Irfan4hmd/Entomoscope_LIB/enimas2-main/UserInterface/imgs/490-415-max.png

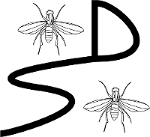
enimas2-main/UserInterface/imgs/490-415-max.png
