Irfan4hmd/Entomoscope_LIB/enimas2-main/UserInterface/imgs/camera_settings.png

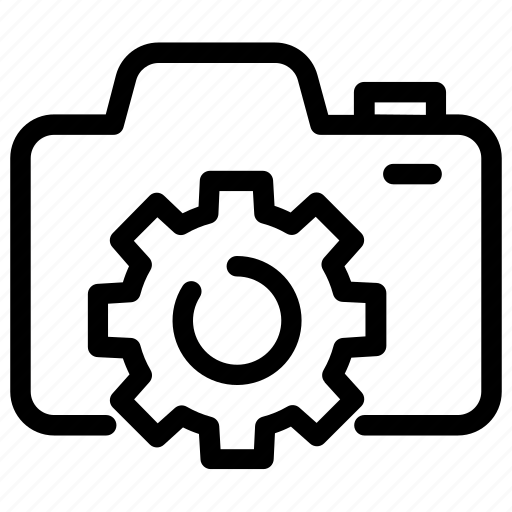
enimas2-main/UserInterface/imgs/camera_settings.png
