Irfan4hmd/Entomoscope_LIB/enimas2-main/UserInterface/imgs/reference_axis.png

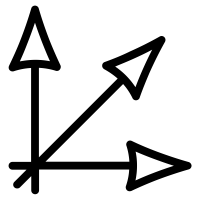
enimas2-main/UserInterface/imgs/reference_axis.png
