Irfan4hmd/Entomoscope_LIB/enimas2-main/UserInterface/imgs/take_stack.png

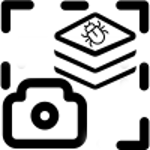
enimas2-main/UserInterface/imgs/take_stack.png
