Irfan4hmd/Entomoscope_LIB/enimas2-main/UserInterface/Wiki_Images/arduino_device_choice.png

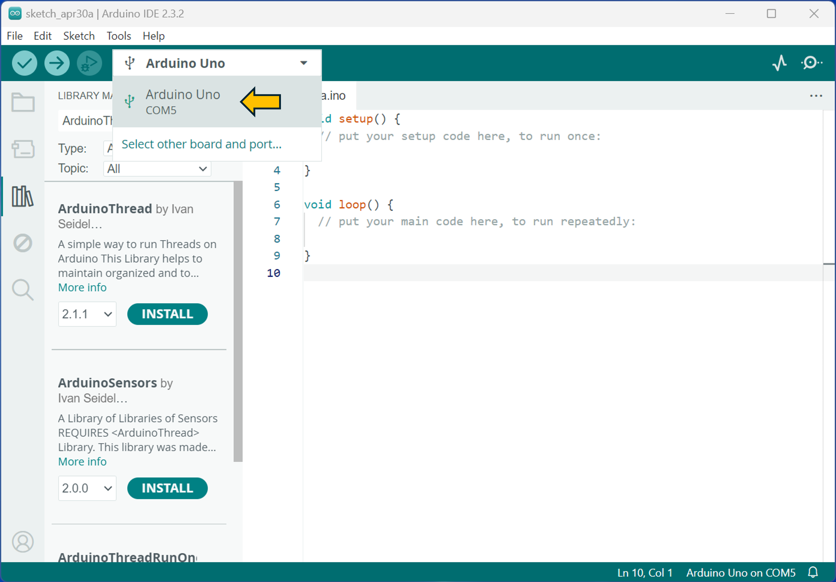
enimas2-main/UserInterface/Wiki_Images/arduino_device_choice.png
