Irfan4hmd/Entomoscope_LIB/enimas2-main/UserInterface/Wiki_Images/arduino_library_manager.png

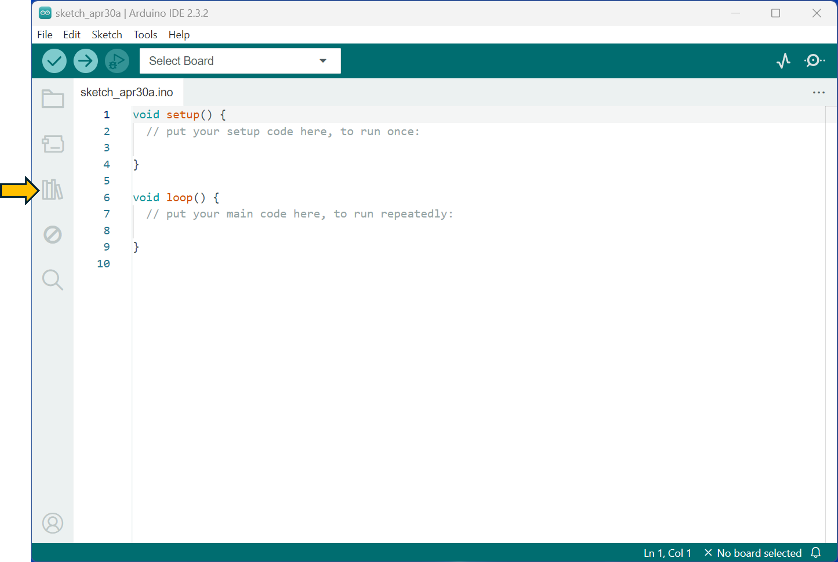
enimas2-main/UserInterface/Wiki_Images/arduino_library_manager.png
