Irfan4hmd/Entomoscope_LIB/enimas2-main/UserInterface/Wiki_Images/base_plate_explosion_arduino.png

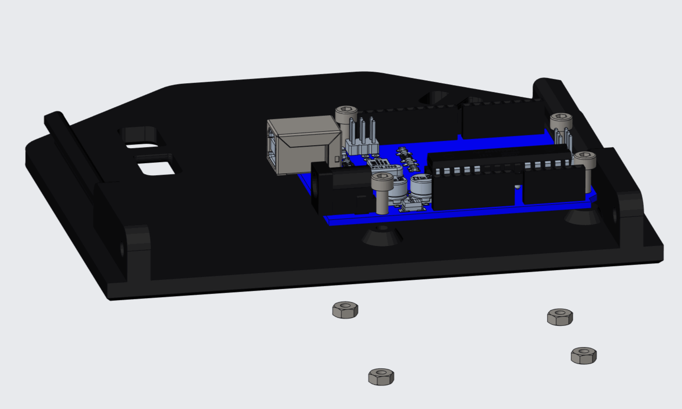
enimas2-main/UserInterface/Wiki_Images/base_plate_explosion_arduino.png
