Irfan4hmd/Entomoscope_LIB/enimas2-main/UserInterface/Wiki_Images/base_plate_final.jpg

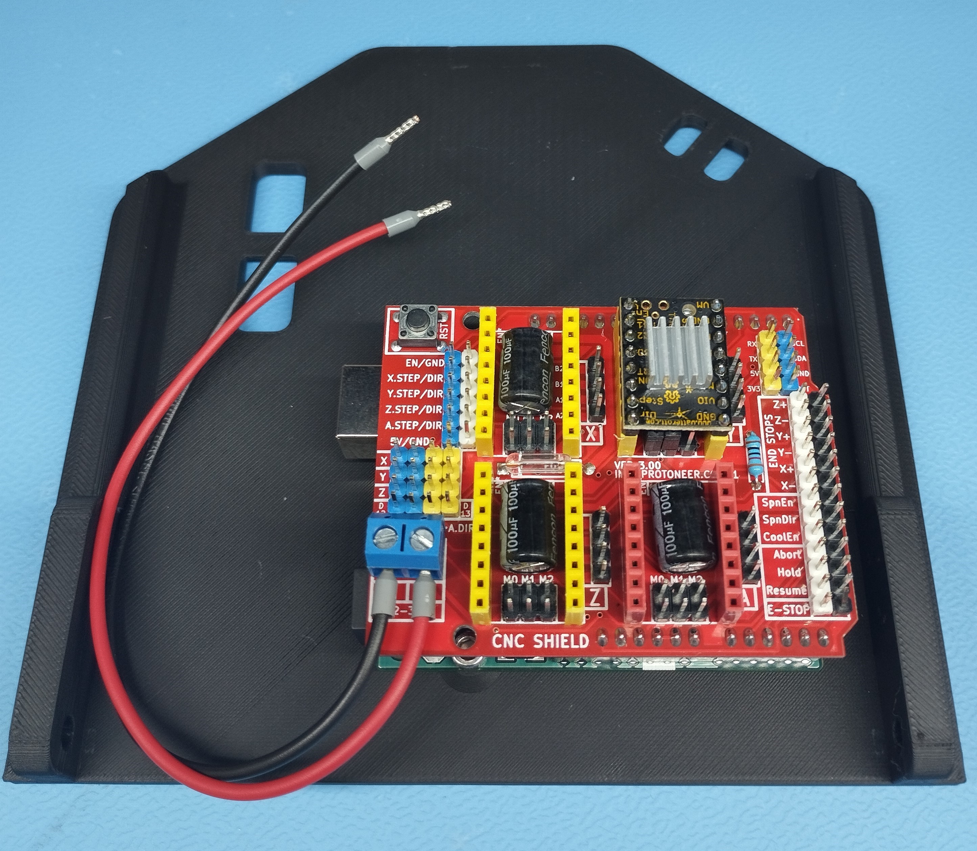
enimas2-main/UserInterface/Wiki_Images/base_plate_final.jpg
