Irfan4hmd/Entomoscope_LIB/enimas2-main/UserInterface/Wiki_Images/bearing_alignment.jpg

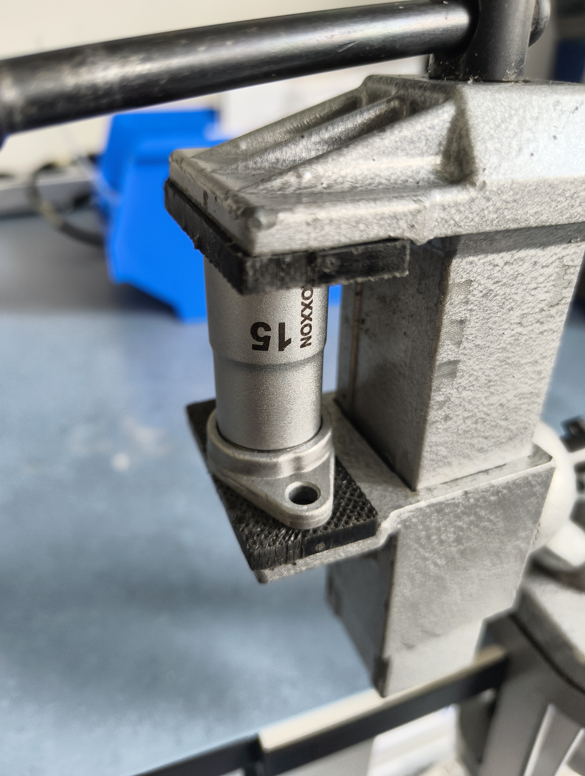
enimas2-main/UserInterface/Wiki_Images/bearing_alignment.jpg
