Irfan4hmd/Entomoscope_LIB/enimas2-main/UserInterface/Wiki_Images/cable_brackets.JPG

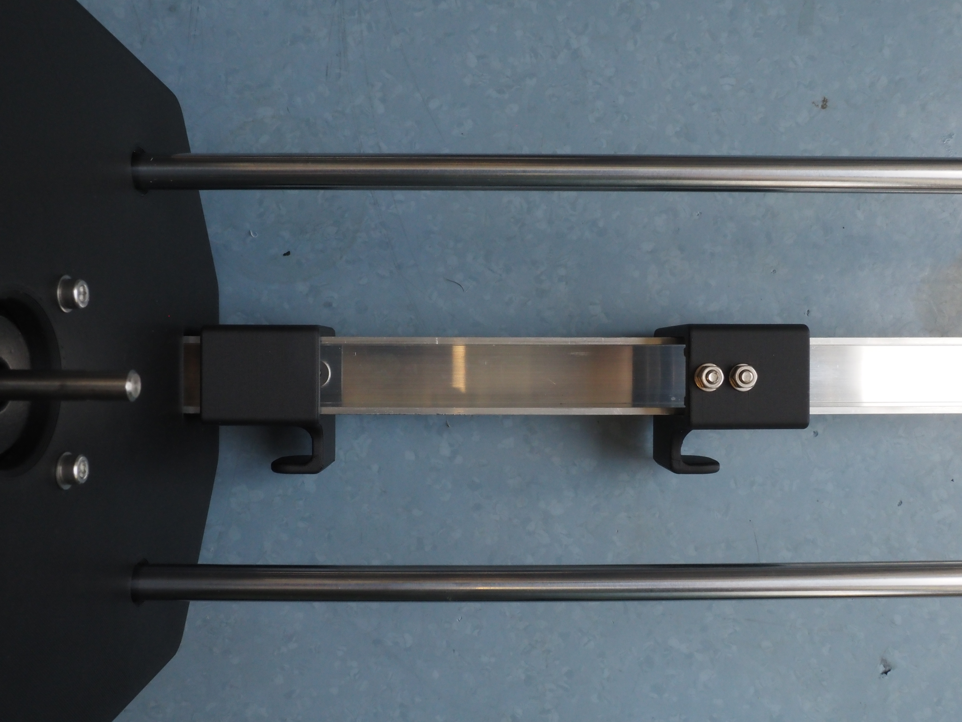
enimas2-main/UserInterface/Wiki_Images/cable_brackets.JPG
