Irfan4hmd/Entomoscope_LIB/enimas2-main/UserInterface/Wiki_Images/camera_carrier_explosion.png

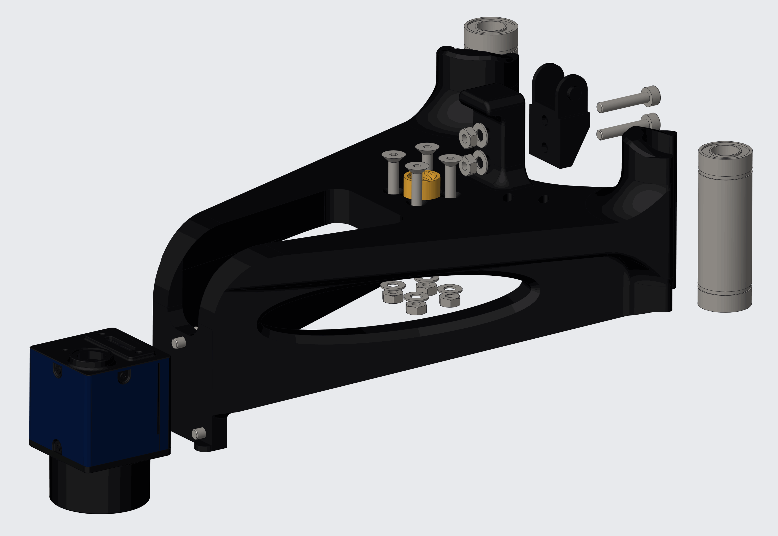
enimas2-main/UserInterface/Wiki_Images/camera_carrier_explosion.png
