Irfan4hmd/Entomoscope_LIB/enimas2-main/UserInterface/Wiki_Images/clamps_explosion.png

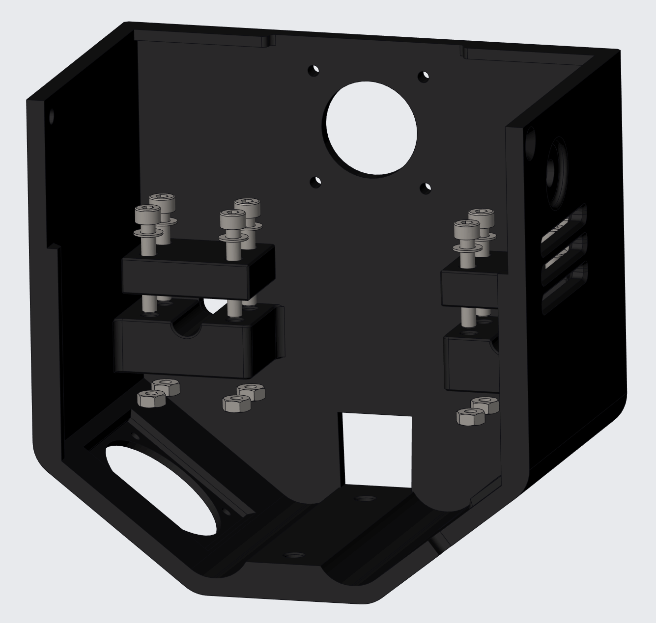
enimas2-main/UserInterface/Wiki_Images/clamps_explosion.png
