Irfan4hmd/Entomoscope_LIB/enimas2-main/UserInterface/Wiki_Images/cnc_shield_jumpers.png

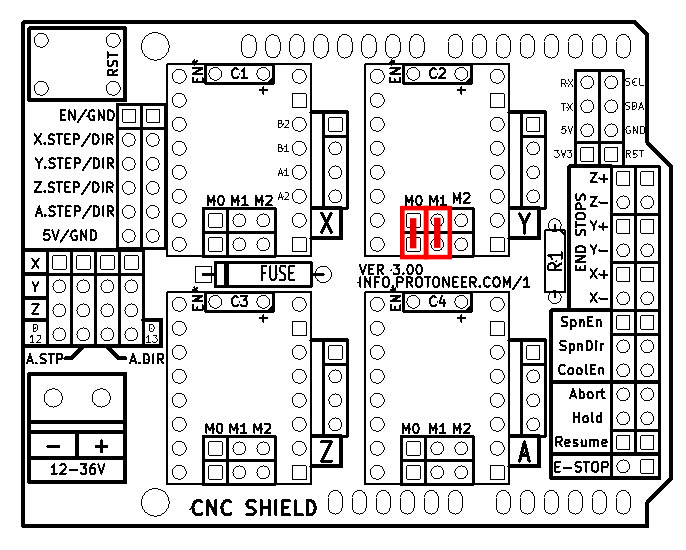
enimas2-main/UserInterface/Wiki_Images/cnc_shield_jumpers.png
