Irfan4hmd/Entomoscope_LIB/enimas2-main/UserInterface/Wiki_Images/coupler_distance.jpg

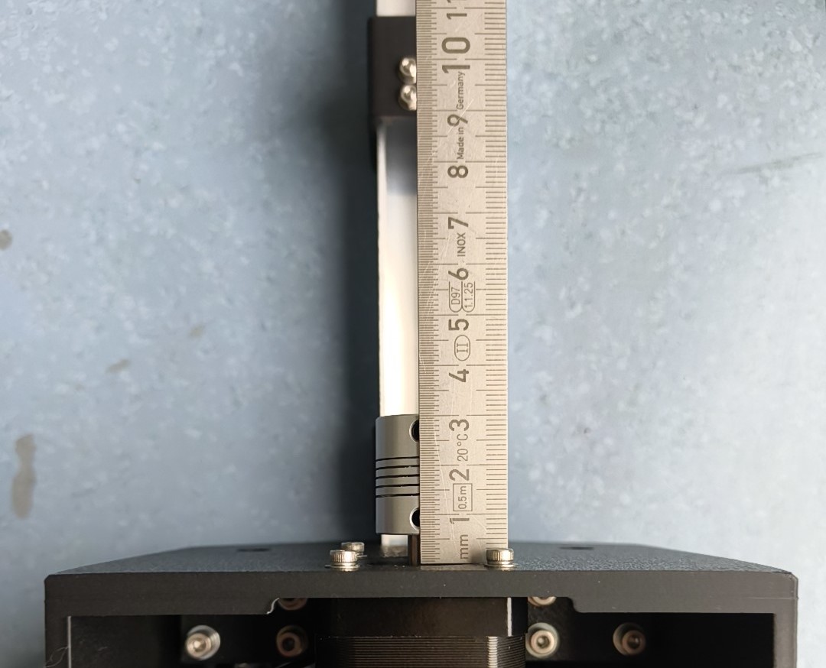
enimas2-main/UserInterface/Wiki_Images/coupler_distance.jpg
