Irfan4hmd/Entomoscope_LIB/enimas2-main/UserInterface/Wiki_Images/diffuser_plates.jpg

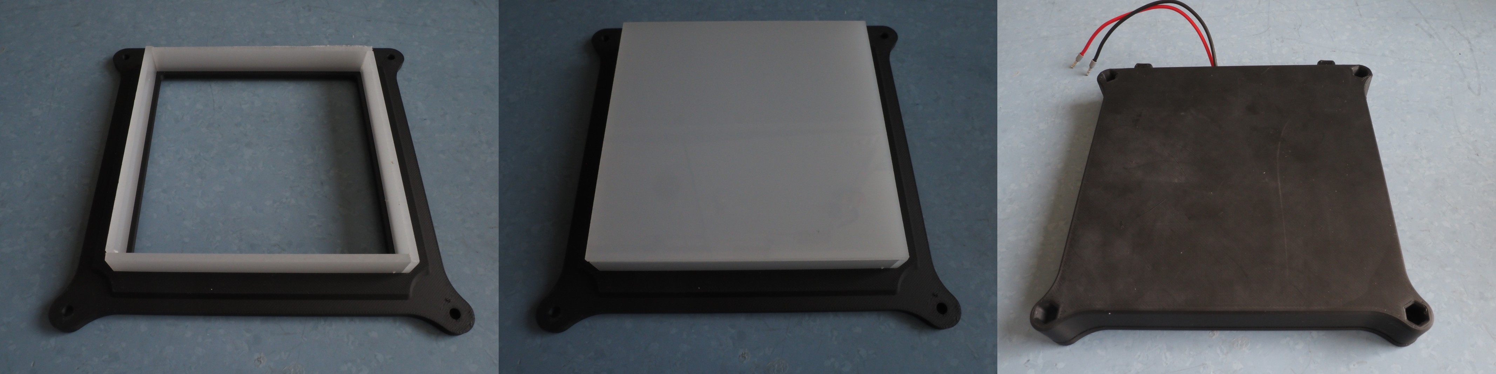
enimas2-main/UserInterface/Wiki_Images/diffuser_plates.jpg
