Irfan4hmd/Entomoscope_LIB/enimas2-main/UserInterface/Wiki_Images/drag_chain.jpg

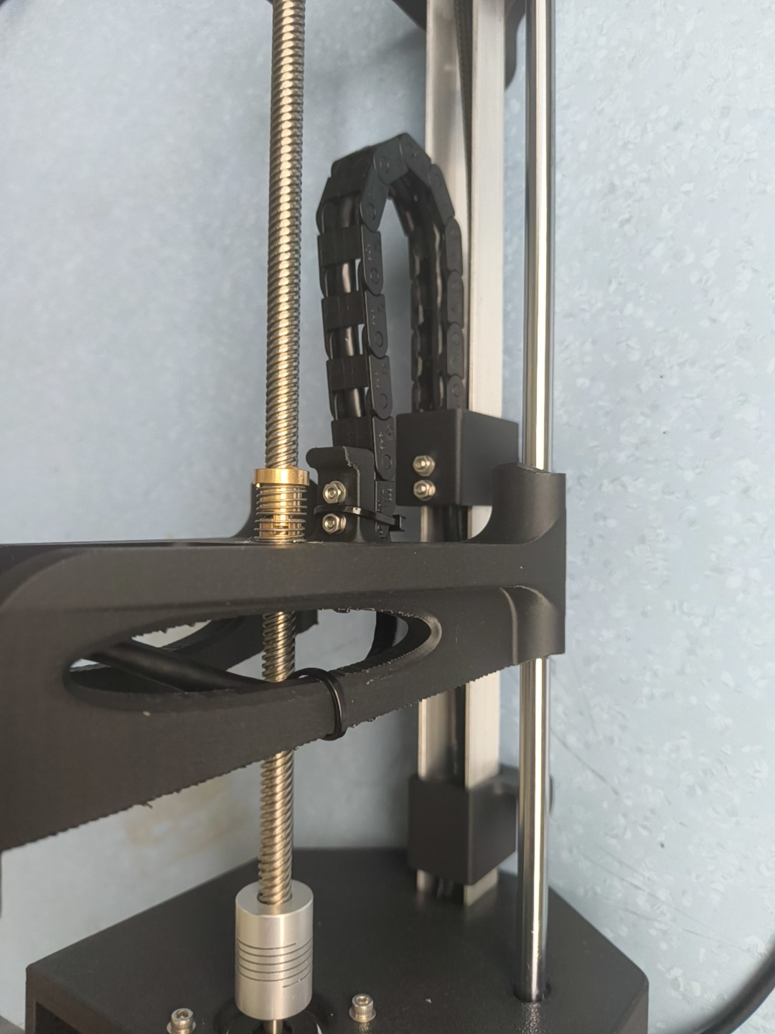
enimas2-main/UserInterface/Wiki_Images/drag_chain.jpg
