Irfan4hmd/Entomoscope_LIB/enimas2-main/UserInterface/Wiki_Images/drag_chain_bracket_explosion.png

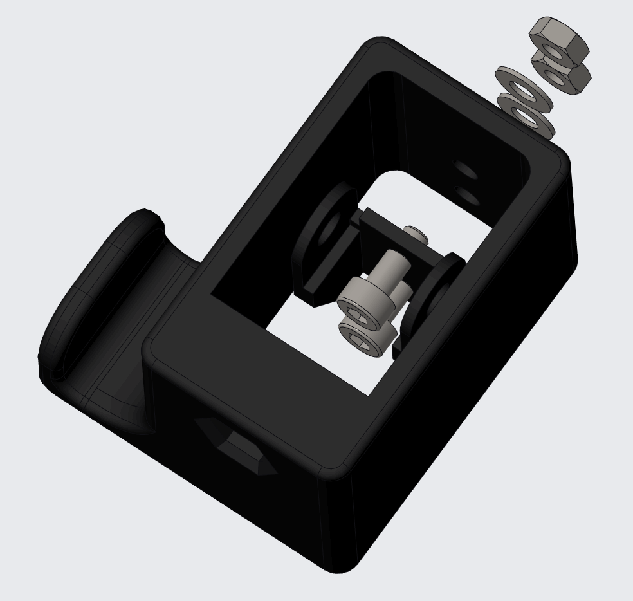
enimas2-main/UserInterface/Wiki_Images/drag_chain_bracket_explosion.png
