Irfan4hmd/Entomoscope_LIB/enimas2-main/UserInterface/Wiki_Images/electronics_base.JPG

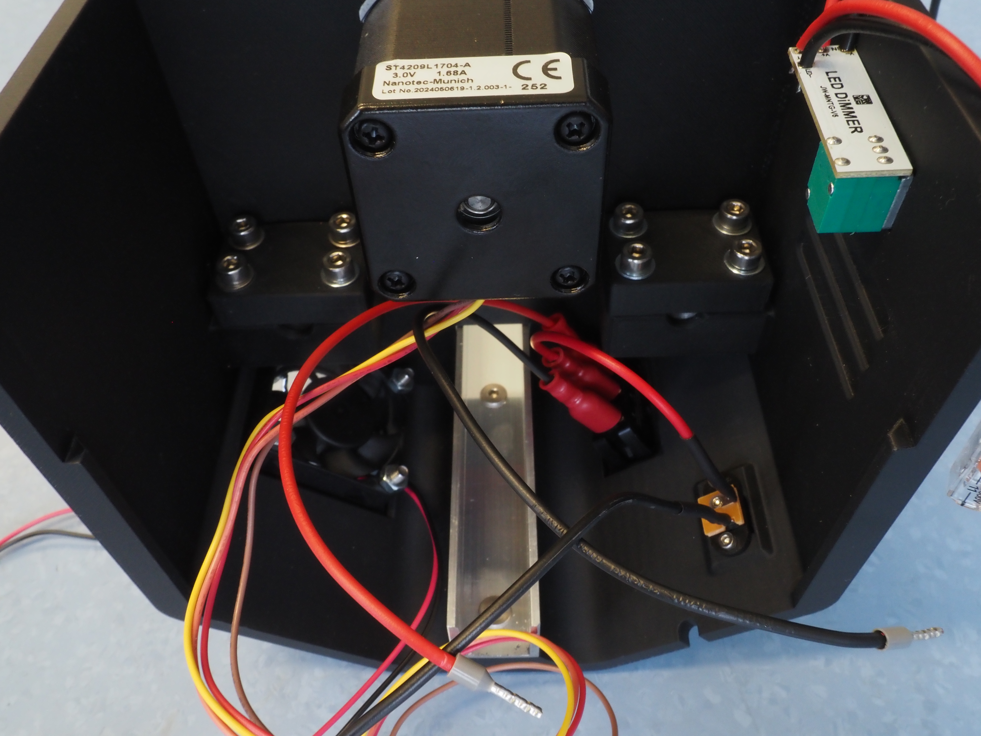
enimas2-main/UserInterface/Wiki_Images/electronics_base.JPG
