Irfan4hmd/Entomoscope_LIB/enimas2-main/UserInterface/Wiki_Images/endswitch_circuit_diagram.png

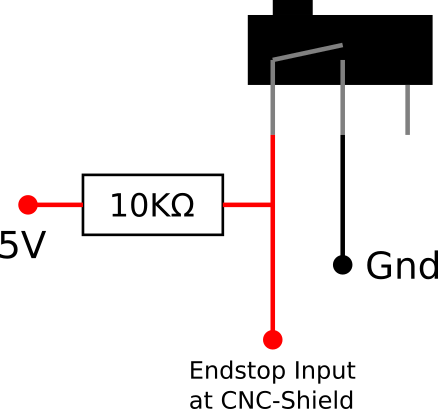
enimas2-main/UserInterface/Wiki_Images/endswitch_circuit_diagram.png
