Irfan4hmd/Entomoscope_LIB/enimas2-main/UserInterface/Wiki_Images/endswitch_cnc_connection.png

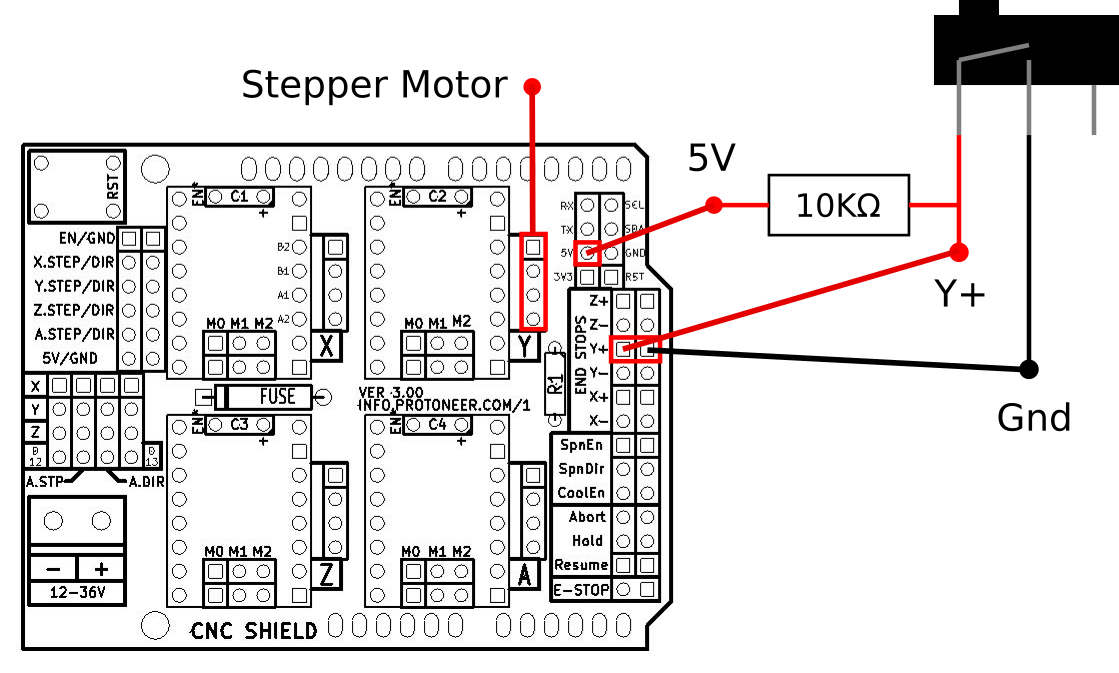
enimas2-main/UserInterface/Wiki_Images/endswitch_cnc_connection.png
