Irfan4hmd/Entomoscope_LIB/enimas2-main/UserInterface/Wiki_Images/lighting_unit_explosion.png

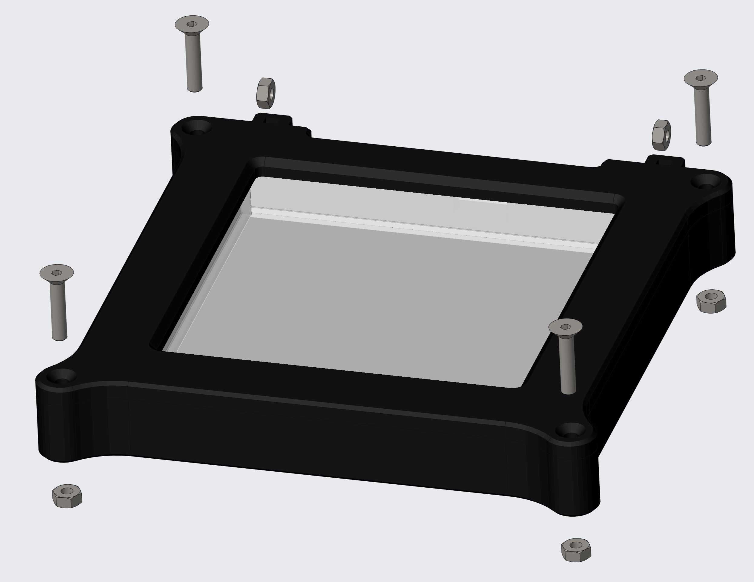
enimas2-main/UserInterface/Wiki_Images/lighting_unit_explosion.png
