Irfan4hmd/Entomoscope_LIB/enimas2-main/UserInterface/Wiki_Images/linear_top_explosion.png

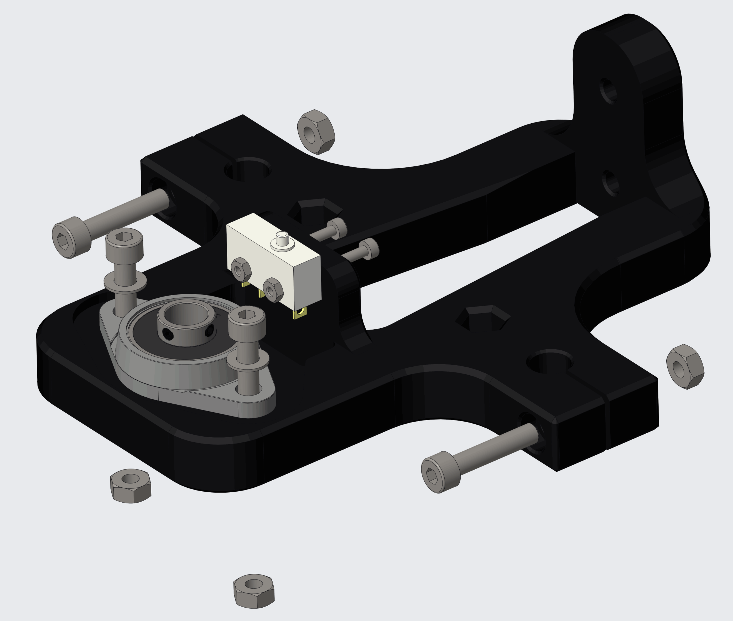
enimas2-main/UserInterface/Wiki_Images/linear_top_explosion.png
