Irfan4hmd/Entomoscope_LIB/enimas2-main/UserInterface/Wiki_Images/power_supply_cables.jpg

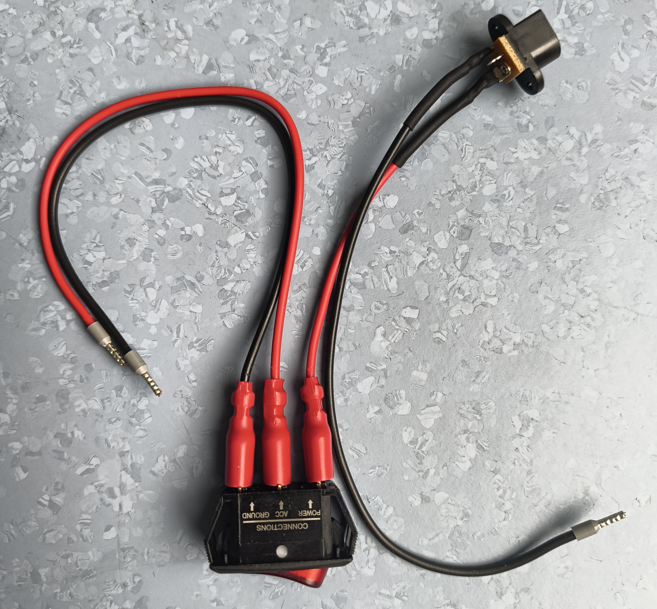
enimas2-main/UserInterface/Wiki_Images/power_supply_cables.jpg
