Irfan4hmd/Entomoscope_LIB/enimas2-main/UserInterface/Wiki_Images/tilted_bearing.jpg

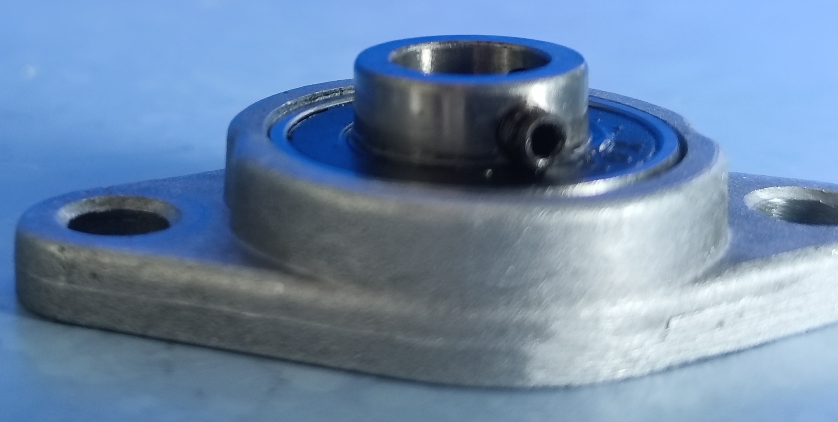
enimas2-main/UserInterface/Wiki_Images/tilted_bearing.jpg
