Irfan4hmd/Entomoscope_LIB/enimas2-main/UserInterface/Wiki_Images/top_alignment.jpg

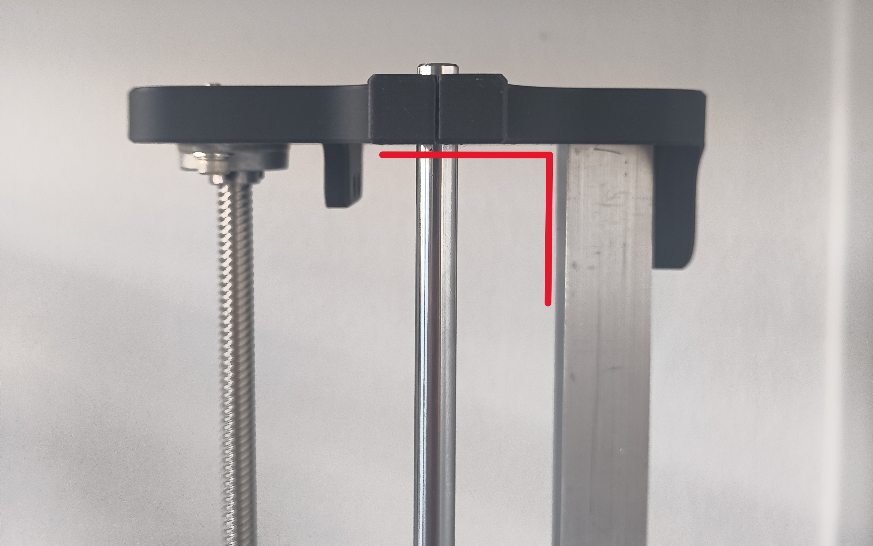
enimas2-main/UserInterface/Wiki_Images/top_alignment.jpg
