Irfan4hmd/Entomoscope_LIB/enimas2-main/UserInterface/Wiki_Images/top_cable.JPG

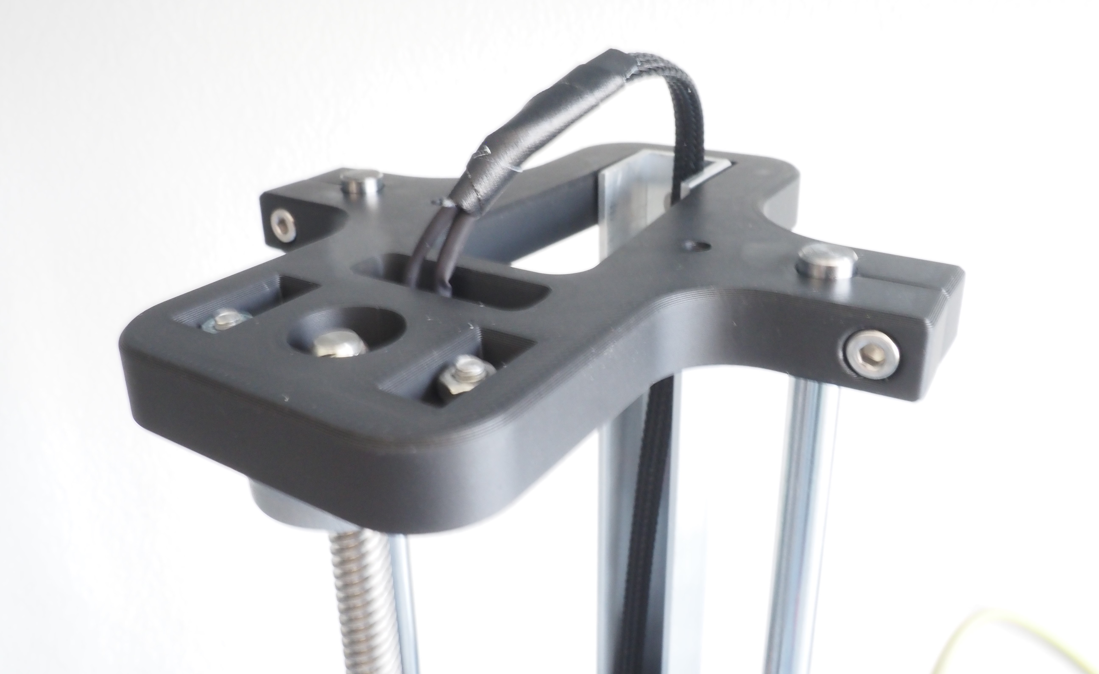
enimas2-main/UserInterface/Wiki_Images/top_cable.JPG
