Irfan4hmd/Entomoscope_LIB/enimas2-main/UserInterface/Wiki_Images/top_lid.JPG

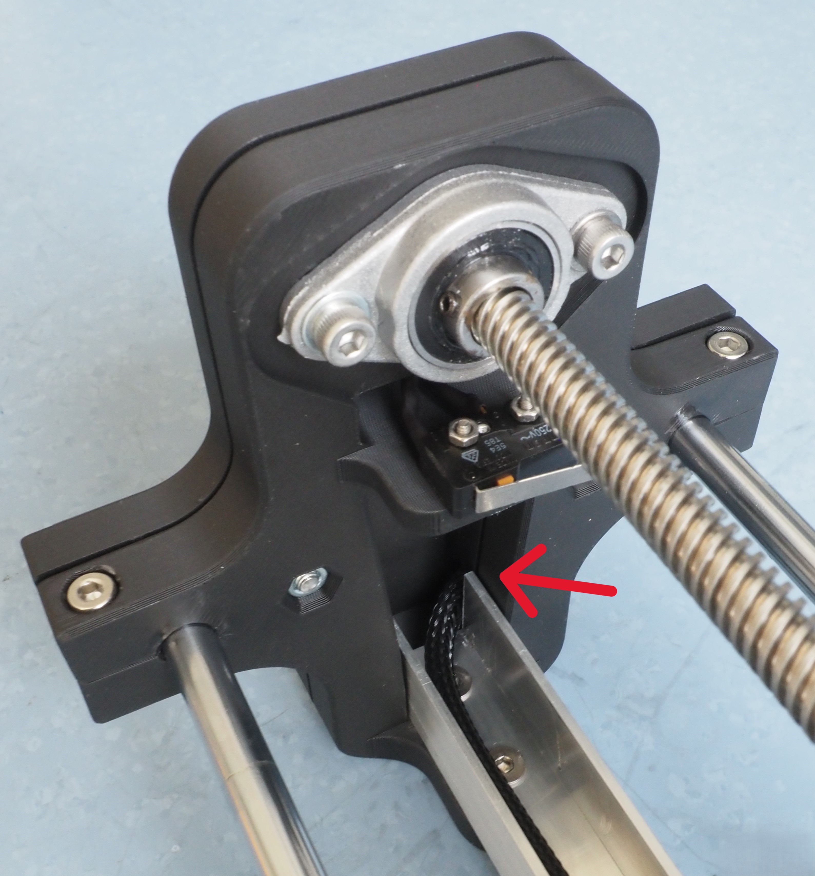
enimas2-main/UserInterface/Wiki_Images/top_lid.JPG
