Irfan4hmd/Entomoscope_LIB/enimas2-main/UserInterface/Wiki_Images/u-profile_explosion.png

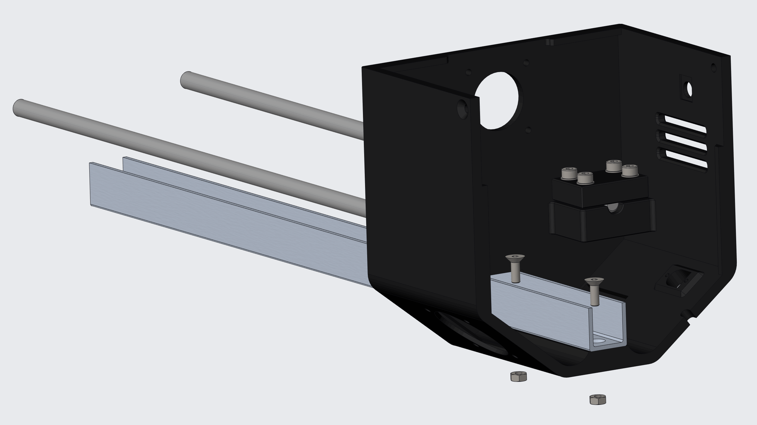
enimas2-main/UserInterface/Wiki_Images/u-profile_explosion.png
