Irfan4hmd/Entomoscope_LIB/enimas2-main/UserInterface/Wiki_Images/usb_hub.jpg

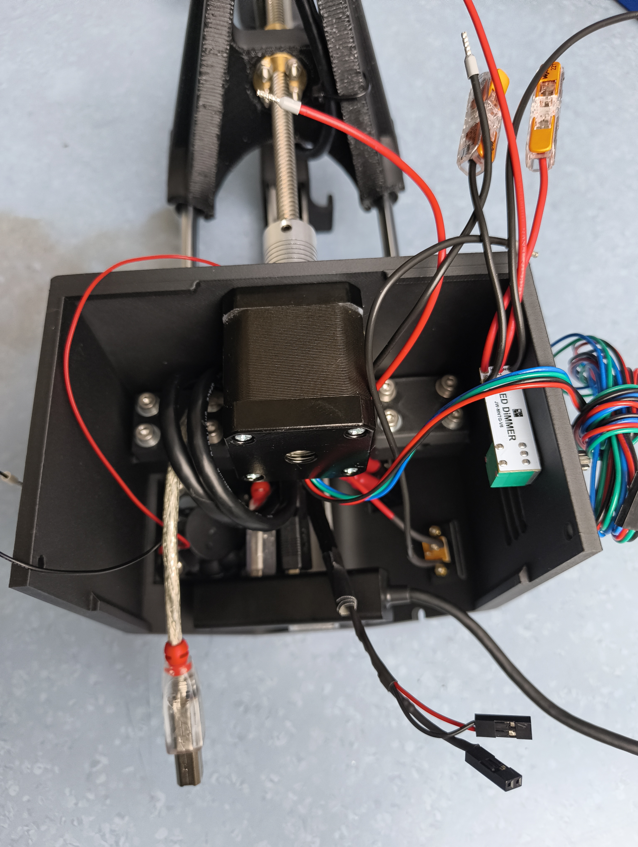
enimas2-main/UserInterface/Wiki_Images/usb_hub.jpg
