Irfan4hmd/Entomoscope_LIB/enimas2-main/UserInterface/Partslist/Entomoscope_2_0_Partslist_NEW.xlsx

Sheet: Entomoscope 3.0 Parts
Category | Part |  | Category | Description | Quantity per Set Up | Link | Price/unit | Total | Units/Assembly | In Stock | Estimated Filament use (for 3D-printed parts only) [g] | Estimated printing time (for 3D-printed parts only)
Base_Assembly | Base |  | 3D Printed |  | 1 |  |  | 0.94 |  |  | 59
 | CNC_Shield |  | Purchased | CNC Shield V3 Arduino UNO | 1 | https://www.roboter-bausatz.de/p/uno-cnc-shield-v3-kompatibel-mit-arduino-uno | 5.22 | 5.22 | 1 | 21 | NaN |  | Filament price €/kg | 16
 | Arduino UNO | Options | Purchased | UNO R3 ATMEGA328P Board Arduino kompatibel | 1 | https://www.roboter-bausatz.de/p/uno-r3-atmega328p-atmega16u2-board-arduino-kompatibel | 9.95 | 9.95 | 1 | 25 | NaN
 |  |  | Purchased | Joy-it ARD_R3DIP-P (Reichelt) | 0 | https://www.reichelt.de/de/de/shop/produkt/arduino_kompatibles_uno_board_atmega328p-395380 | 13.70 | 0.00 |  |  | NaN
 |  |  | Purchased | Joy-it ARD_R3DIP-P (Conrad) | 0 | https://www.conrad.de/de/p/joy-it-ard-r3dip-p-mikrocontroller-arduino-r3dip-precision-uno-kompatible-3344408.html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 | 14.90 | 0.00 |  |  | NaN
 | Stepper_Driver |  | Purchased | TMC 2209 Stepper Motor Driver | 1 | https://www.roboter-bausatz.de/p/mks-tmc2209-schrittmotortreiber | 5.95 | 5.95 | 1 | 1 | NaN
 | LED_Dimmer |  | Purchased | LED Dimmer DC 3.7 - 24V | 1 | https://www.roboter-bausatz.de/p/led-dimmer-spannungswandler-modul-dc-3-7-24v | 4.62 | 4.62 | 1 | 15 | NaN
 | Dimmer_Button |  | Purchased | Potentiometer Knobs 30 PACK | 0.03333333333 | https://www.roboter-bausatz.de/p/sortiment-potentiometer-knoepfe-30-stueck | 1.39 | 0.05 | 1 | 20 | NaN
 | Wago_221_2 |  | Purchased | Wago 221 Splicing Connector, 1 Conductor | 2 | https://www.conrad.de/de/p/wago-221-2411-verbindungsklemme-flexibel-0-14-4-mm-starr-0-2-4-mm-polzahl-1-1-st-transparent-orange-2355190.html | 0.52 | 1.04 | 2 | >20 | NaN
 | Wago_221_5 |  | Purchased | Wago 221 Splicing Connector, 5 Conductor | 2 | https://www.conrad.de/de/p/wago-221-415-1-221-verbindungsklemme-flexibel-0-14-4-mm-starr-0-2-4-mm-polzahl-5-1-st-transparent-orange-1188438.html | 1.49 | 2.98 | 2 | 9 | NaN
 | USB_Hub |  | Purchased | Axagon 4 Port | 1 | https://www.reichelt.de/de/de/shop/produkt/usb_3_0_4-port_hub_4xa_usb-a-kabel_120_cm-346300 | 13.90 | 13.90 | 1 | 15 | NaN
 | USB-Cable |  | Purchased | USB A to B, 0.2m | 1 | https://www.reichelt.de/de/de/shop/produkt/usb_2_0_kabel_a_stecker_auf_b_stecker_0_2_m-378352 | 2.15 | 2.15 | 1 | 20 | NaN
 |  |  |  |  |  |  |  | 0.00
Linear_Assembly | Linear_Rail_Base |  | 3D Printed |  | 1 |  |  | 2.40 |  |  | 150
 | Linear_Rail_Top |  | 3D Printed |  | 1 |  |  | 0.80 |  |  | 50
 | Linear_Rod_Clamp |  | 3D Printed |  | 2 |  |  | 0.08 |  |  | 5
 | Linear_Rail_Top_lid |  | 3D Printed |  | 1 |  |  | 0.61 |  |  | 38
 | Linear_Rod |  | Purchased | 350x8mm | 2 | https://www.roboter-bausatz.de/p/linearwelle-8-mm-x-350-mm | 6.65 | 13.30 | 2 | 15 | NaN
 | Threaded_Rod_T8x8 |  | Purchased | 300x8mm | 1 | https://www.roboter-bausatz.de/p/trapezgewindespindel-fuer-3d-drucker-fraese-usw.-300x8mm-edelstahl-messingmutter | 7.95 | 7.95 | 1 | 20 | NaN
 | U-Profile |  |  |  | 1 |  |  | 0.00 |  | 1 | NaN
 | KFL08 |  | Purchased | 8mm Bearing with Flange 2 PACK | 0.5 | https://www.roboter-bausatz.de/p/kfl08-stehlager-mit-flansch-2-stueck | 3.71 | 1.85 | 1 | 10 | NaN
 | 5-8mm_Shaft_Coupler | Options | Purchased | Flexible Coupler | 1 | https://www.roboter-bausatz.de/p/flexible-wellenkupplung-5mm-auf-8mm | 1.55 | 1.55 | 1 | 18 | NaN
 |  |  | Purchased | Claw Coupler D20L25 | 0 | https://www.roboter-bausatz.de/p/5-mm-auf-8-mm-klauenkupplung-wellenkupplung-d20l25 | 4.99 | 0.00 |  |  | NaN
 | Stepper_Motor | Options | Purchased | Joy-IT, Nema 17 (Reichelt) | 1 | https://www.reichelt.de/de/de/shop/produkt/schrittmotor_hoch-drehmoment_hybrid_2-phasen-219027 | 25.80 | 25.80 | 1 | 19 | NaN
 |  |  | Purchased | Joy-IT, Nema 17 (Conrad) | 0 | https://www.conrad.de/de/p/joy-it-schrittmotor-nema-17-01-nema-17-01-0-4-nm-1-68-a-wellen-durchmesser-5-mm-1597325.html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 | 29.99 | 0.00 |  |  | NaN
 | 12V_DC_Fan | Options | Purchased | 40x40mm for 3D Printer Hot End | 1 | https://www.roboter-bausatz.de/p/12v-luefter-40-40-10mm-fuer-extruder-hot-end | 1.09 | 1.09 | 1 | 12 | NaN
 |  |  | Purchased | 40x40mm Sunon HA40101V4-1000U-A99 | 0 | https://www.conrad.de/de/p/sunon-ha40101v4-1000u-a99-axialluefter-12-v-dc-9-2-m-h-l-x-b-x-h-40-x-40-x-10-mm-1719608.html | 3.79 | 0.00 |  |  | NaN
 | Fan_Cover |  | Purchased | 40x40mm Fan Cover | 1 | https://www.roboter-bausatz.de/p/extruder-lueftergitter-40x40-mm?number=RBS10717 | 0.49 | 0.49 | 1 | 12 | NaN
 | Power_Supply_Socket | Options | Purchased | DC Power Socket 5.5-2.1mm (Reichelt) | 1 | https://www.reichelt.de/de/de/shop/produkt/einbaubuchse_geschlossen_aussen_6_2_mm_innen_2_1_mm-35271 | 1.30 | 1.30 | 1 | 15 | NaN
 |  |  | Purchased | DC Power Socket 5.5-2.1mm (Conrad) | 0 | https://www.conrad.de/de/p/cliff-dc-13a-niedervolt-steckverbinder-buchse-einbau-horizontal-5-5-mm-2-1-mm-1-st-735766.html | 1.49 | 0.00 |  |  | NaN
 | Power_Switch |  | Purchased | TC-R13-242B2 12 V/DC 25 A | 1 | https://www.conrad.de/de/p/tru-components-wippschalter-tc-r13-242b2-12-v-dc-25-a-1-x-aus-ein-rastend-1-st-1588028.html | 3.29 | 3.29 | 1 | 16 | NaN
 | Reference_Switch | Options | Purchased | Microswitch 250 V 5A (Reichelt) | 1 | https://www.reichelt.de/de/de/shop/produkt/mikroschalter_250_v_5a_1_wechsler_flachhebel-375529 | 0.70 | 0.70 | 1 | 10 | NaN
 |  |  | Purchased | Microswitch 250 V 5A (Conrad) | 0 | https://www.conrad.de/de/p/tru-components-tc-9122112-mikroschalter-250-v-ac-5-a-1-x-ein-ein-tastend-1-st-2280528.html | 1.49 | 0.00 |  |  | NaN
 | Energy_Chain | TBD | Purchased | 1m, 7x7mm inner diameter, closed | 0 | https://www.roboter-bausatz.de/p/1-meter-schleppkette-zur-kabelfuehrung-7x7mm | 4.39 | 0.00 |  |  | NaN
 |  |  | Purchased | Igus E04 7x7mm inner diameter, open | 13 | https://www.igus.de/product/series-E04?artnr=E04.07.038.0 | 0.32 | 4.16 | 15 | >100 | NaN
 |  |  |  |  |  |  |  | 0.00
Linear_Carriage_Assembly | Camera_Carriage |  | 3D Printed |  | 1 |  |  | 1.60 |  |  | 100
 | Linear_Bearing |  | Purchased | Misumi LM8UU Long | 2 | https://www.roboter-bausatz.de/p/misumi-lm8luu-lmuw8-linearlager | 8.45 | 16.90 | 2 | 25 | NaN
 | Shaft_Nut_Anti_Backlash |  | Purchased | T8x8 Shaft Nut with Anti Backlash | 1 | https://www.roboter-bausatz.de/p/t8x8-anti-backlash-gefederte-messingmutter-fuer-z-achse | 2.45 | 2.45 | 1 | 7 | NaN
 | Camera_MER2 |  | Purchased | VA-Imaging, MER2-1220-32U3C | 1 | https://va-imaging.com/de/products/usb3-0-camera-12-2mp-color-sony-imx226-mer2-1220-32u3c | 252.00 | 252.00 |  |  | NaN
 | USB_Cable |  | Purchased | USB 3.0 Cable, A to Micro-B, 1m | 1 | https://www.reichelt.de/de/de/shop/produkt/usb_5_gb_s_kabel_a_stecker_auf_90_micro-b_18_mm_m2_1_0_m-394204 | 14.95 | 14.95 | 1 | 15 | NaN
 |  |  |  |  |  |  |  | 0.00
 |  |  |  |  |  |  |  | 0.00
Lighting_Assembly | Lighting_Base |  | 3D Printed |  | 1 |  |  | 1.36 |  |  | 85
 | Lighting_Lid |  | 3D Printed |  | 1 |  |  | 0.61 |  |  | 38
 | Diffusor_Plate |  | Manufactured |  | 1 |  |  | 0.00 | 1 | 4 | NaN
 | Diffusor_Side_Plate |  | Manufactured |  | 4 |  |  | 0.00 | 4 | 16 | NaN
 | LED_Strip |  | Purchased | LED Strip 5mx8mm, 12VDC | 0.088 | https://de.rs-online.com/web/p/led-streifen-led-bander/8904408 | 82.94 | 7.30 | 45cm
 |  |  |  |  |  |  |  | 0.00
 |  |  |  |  |  |  |  | 0.00
Power_Supply |  | Options | Purchased | 12VDC, 3A, 5.5x2.1mm | 1 | https://www.roboter-bausatz.de/p/yourdroid-netzteil-12v-3a-5-5x2-1mm-dc-stecker | 8.35 | 8.35 | 1 | 9
 |  |  | Purchased | 12VDC, 3A, 5.5x2.1mm | 0 | https://www.conrad.de/de/p/dehner-elektronik-saw-30-120-2000g-steckernetzteil-festspannung-12-v-dc-2000-ma-24-w-1549856.html | 8.99 | 0.00
 | Dupont Connectors |  |  |  |  |  |  | 417.69
 | Cables
 | Ferrules

Sheet: Fasteners
Diameter | M2 |  | M3 |  |  |  |  |  |  |  | M4
Type | CL | N | CL | CL | CL | CL | CS | CS | W | N | CL | CL | CL | CS | CS | CS | W | N
Length | 12 |  | 8 | 10 | 14 | 16 | 8 | 16 |  |  | 16 | 20 | 25 | 10 | 12 | 20
Power Socket | 2 | 2
End Stop Switch | 2 | 2
CNC Shield |  |  | 4 |  |  |  |  |  |  | 4
Fan |  |  |  |  |  | 4 |  |  | 4 | 4
Stepper Motor |  |  | 4 |  |  |  |  |  | 4
Camera Carrier |  |  |  |  | 2 | 4 |  | 4 | 6 | 6
Camera |  |  |  |  |  |  | 3
Energy Chain Brackets |  |  | 2 |  |  |  |  |  | 2 | 2 |  |  |  | 2 |  |  | 2 | 2
Lighting Unit |  |  |  |  |  |  |  |  |  |  |  |  |  |  |  | 4 |  | 4
Clamps |  |  |  |  |  |  |  |  |  |  |  |  | 8 |  |  |  | 8 | 8
U-Profile |  |  |  |  |  |  |  |  |  |  |  |  |  |  | 4 |  |  | 4
Flange Bearing |  |  |  |  |  |  |  |  |  |  | 2 |  |  |  |  |  | 2 | 2
Top Clamp |  |  |  |  |  |  |  |  |  |  |  | 2 |  |  |  |  |  | 2
Top Lid |  |  |  |  |  |  |  |  |  |  |  | 2 |  |  |  |  |  | 2
Baseplate |  |  |  |  |  |  |  |  |  |  |  |  |  |  |  | 2 |  | 2
Sum | 4 | 4 | 10 | 0 | 2 | 8 | 3 | 4 | 16 | 16 | 2 | 4 | 8 | 2 | 4 | 6 | 12 | 26
 | CL | Cylindrical
 | CS | Countersunk
 | W | Washer
 | N | Nut
