Irfan4hmd/Entomoscope_LIB/enimas2-main/UserInterface/Partslist/3D_Printed_Parts/Base/linear_asm_lid.stl

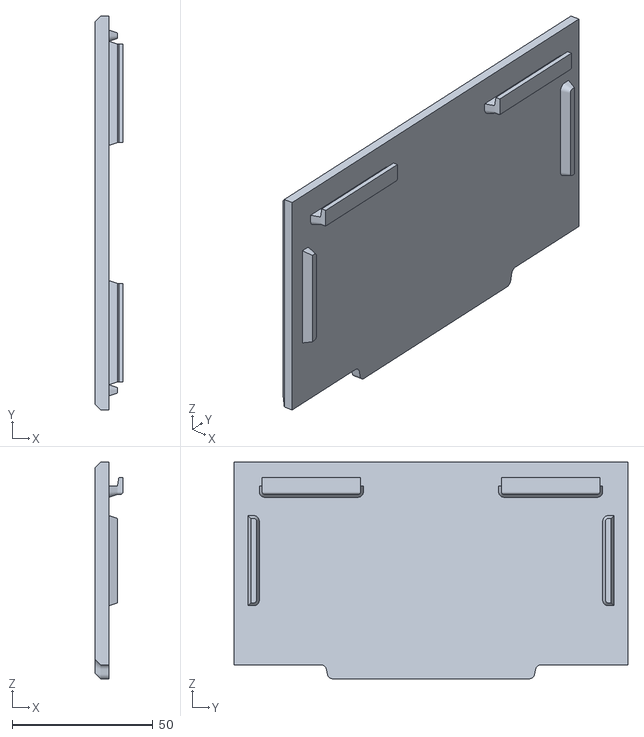
[picture p37: CAD file, 2026-09-22]
enimas2-main/UserInterface/Partslist/3D_Printed_Parts/Base/linear_asm_lid.stl
10.0 x 140.0 x 77.0
