Irfan4hmd/Entomoscope_LIB/enimas2-main/UserInterface/Partslist/3D_Printed_Parts/Base/linear_rail_base.stl

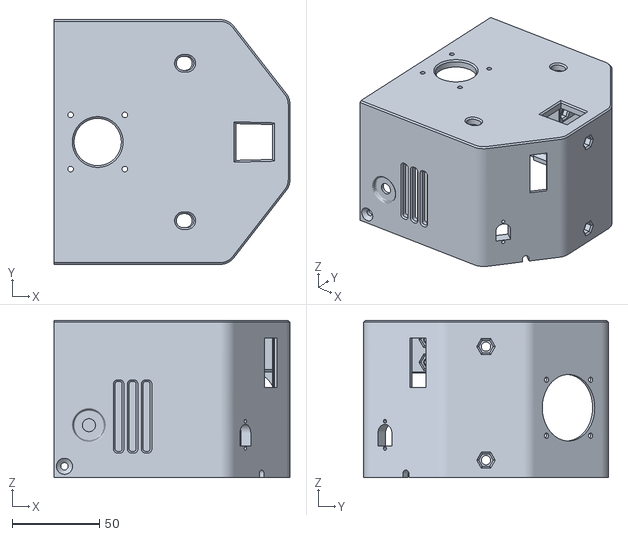
[picture p38: CAD file, 2026-09-22]
enimas2-main/UserInterface/Partslist/3D_Printed_Parts/Base/linear_rail_base.stl
135.0 x 140.0 x 90.0
