Irfan4hmd/Entomoscope_LIB/enimas2-main/UserInterface/Partslist/3D_Printed_Parts/Lighting Unit/lighting_base_square_100mm.stl

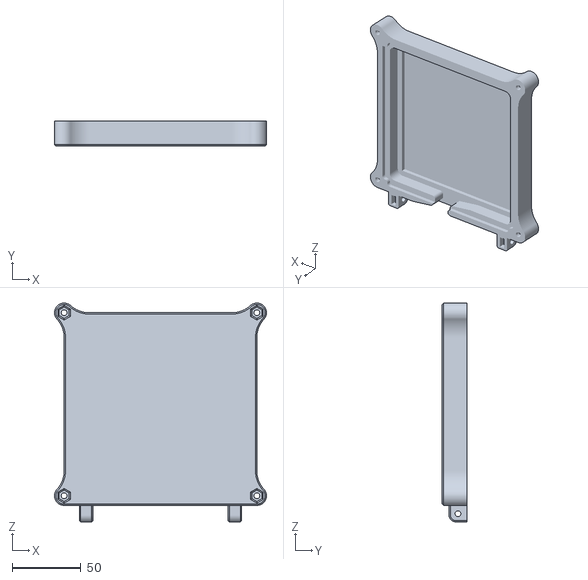
[picture p39: CAD file, 2026-09-22]
enimas2-main/UserInterface/Partslist/3D_Printed_Parts/Lighting Unit/lighting_base_square_100mm.stl
154.0 x 18.0 x 159.0
