Irfan4hmd/Entomoscope_LIB/enimas2-main/UserInterface/Partslist/3D_Printed_Parts/Linear Carriage/cammera_carrier.stl

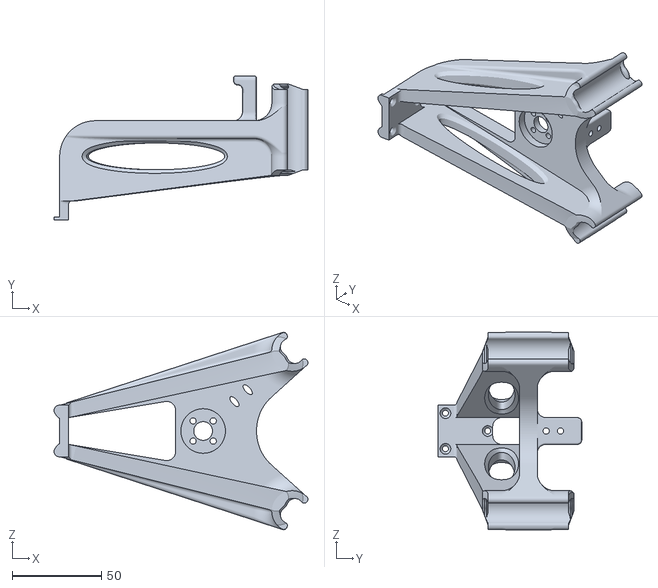
[picture p40: CAD file, 2026-09-22]
enimas2-main/UserInterface/Partslist/3D_Printed_Parts/Linear Carriage/cammera_carrier.stl
142.5 x 80.6 x 110.8
