Irfan4hmd/Entomoscope_LIB/enimas2-main/UserInterface/Partslist/3D_Printed_Parts/Base/linear_rod_clamp.stl

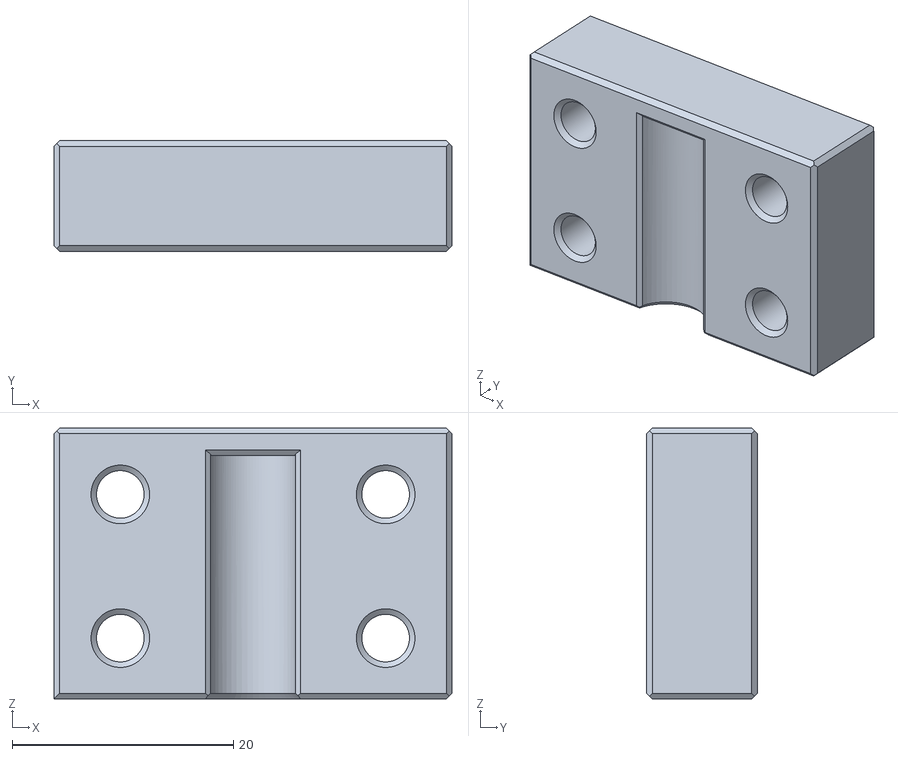
[picture p42: CAD file, 2026-09-22]
enimas2-main/UserInterface/Partslist/3D_Printed_Parts/Base/linear_rod_clamp.stl
36.0 x 10.0 x 24.5
