Irfan4hmd/Entomoscope_LIB/enimas2-main/UserInterface/Partslist/3D_Printed_Parts/Lighting Unit/lighting_lid_square_100mm.stl

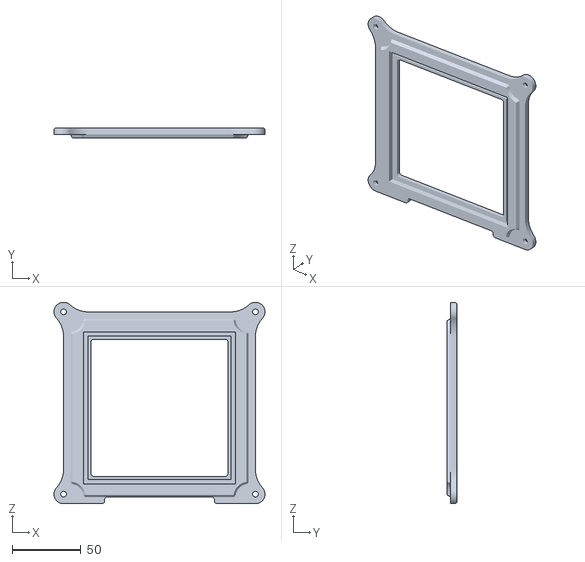
[picture p44: CAD file, 2026-09-22]
enimas2-main/UserInterface/Partslist/3D_Printed_Parts/Lighting Unit/lighting_lid_square_100mm.stl
154.0 x 7.50 x 147.0
