Irfan4hmd/Entomoscope_LIB/enimas2-main/UserInterface/Partslist/3D_Printed_Parts/Top/linear_rail_top.stl

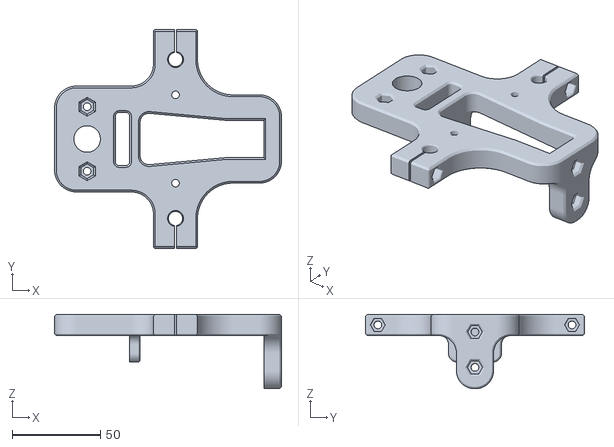
[picture p45: CAD file, 2026-09-22]
enimas2-main/UserInterface/Partslist/3D_Printed_Parts/Top/linear_rail_top.stl
128.5 x 123.9 x 42.0
