Irfan4hmd/Entomoscope_LIB/enimas2-main/UserInterface/Partslist/3D_Printed_Parts/Cable Guides/cable_holder_bracket_bosch.stl

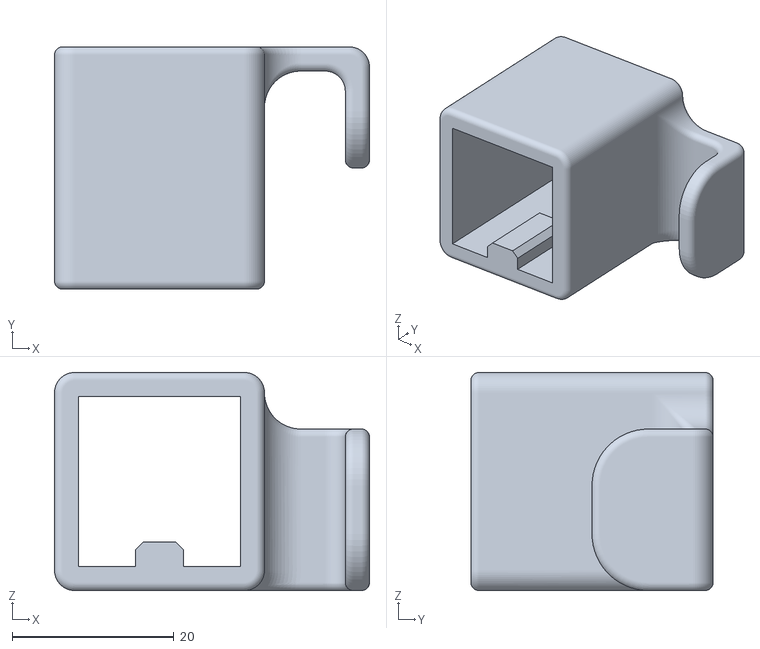
[picture p47: CAD file, 2026-09-22]
enimas2-main/UserInterface/Partslist/3D_Printed_Parts/Cable Guides/cable_holder_bracket_bosch.stl
39.0 x 30.0 x 27.0
