Irfan4hmd/Entomoscope_LIB/enimas2-main/UserInterface/Wiki_Images/arduino_install_ArduinoThread.png

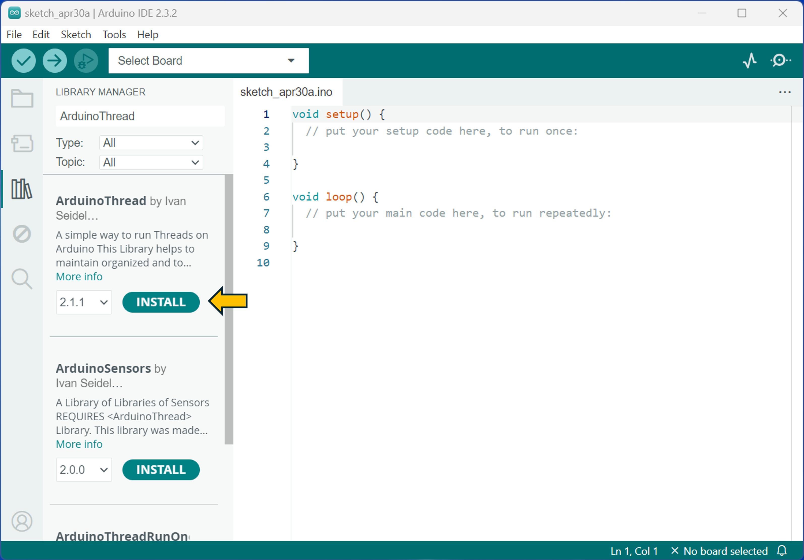
enimas2-main/UserInterface/Wiki_Images/arduino_install_ArduinoThread.png
