Irfan4hmd/Entomoscope_LIB/enimas2-main/UserInterface/Wiki_Images/final_assembly_2.png

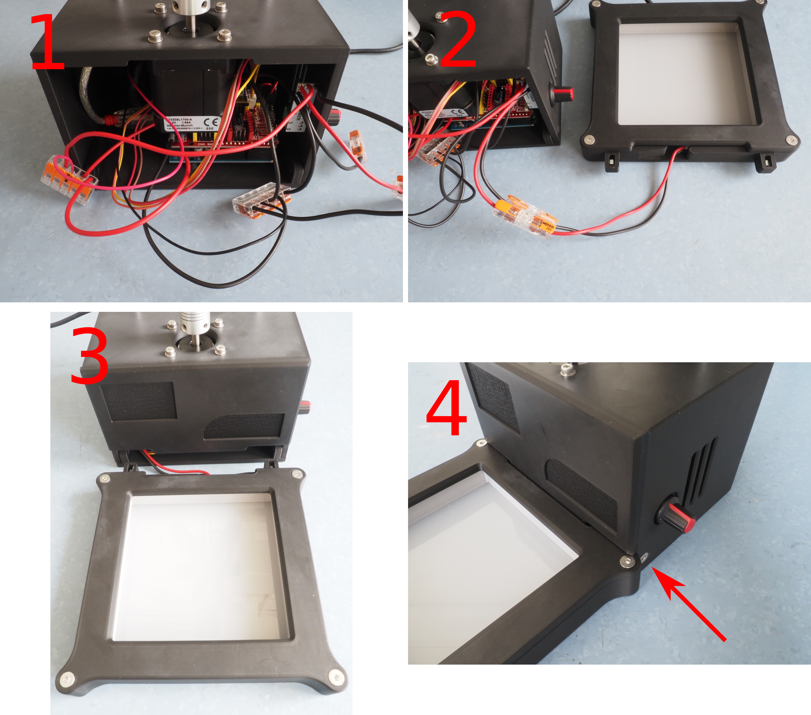
enimas2-main/UserInterface/Wiki_Images/final_assembly_2.png
