Irfan4hmd/Entomoscope_LIB/enimas2-main/UserInterface/Wiki_Images/power_supply_adapter_wiring.png

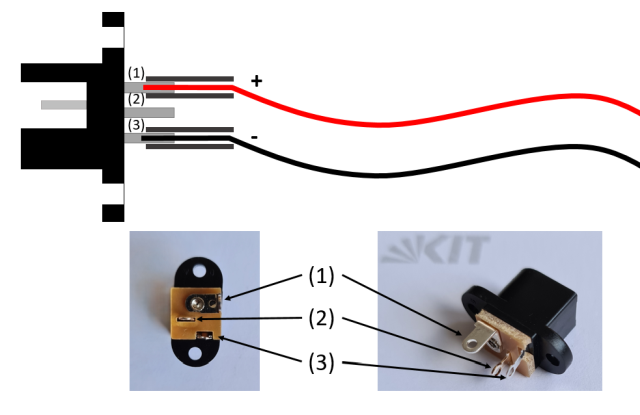
enimas2-main/UserInterface/Wiki_Images/power_supply_adapter_wiring.png
