Irfan4hmd/Entomoscope_LIB/enimas2-main/UserInterface/Wiki_Images/wiring_overview.png

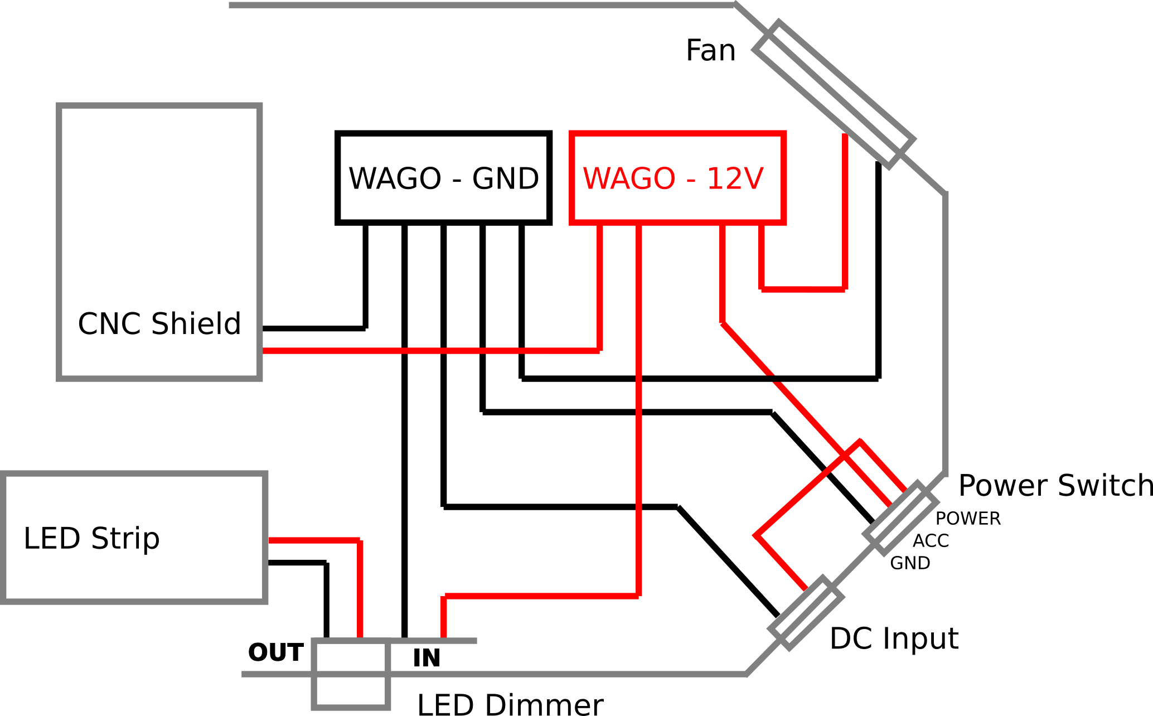
enimas2-main/UserInterface/Wiki_Images/wiring_overview.png
