Irfan4hmd/Entomoscope_LIB/(commit log)

2026-09-22 initialized enimas-2 code
    [Entomoscope_2_0_Partslist_NEW.xlsx, IMX477_2Lane_4032x3040_RAW8_A.cfg, base.stl, cable_holder_bracket_bosch.stl, cable_holder_bracket_u-prof_nut.stl, cammera_carrier.stl, config.txt, energy_chain_bracket_bosch.stl]
2026-09-22 made the changes for autofocus and refrencing bug
    [motorcontroller.py, servo.ino]
2026-09-24 made the changes for autofocus and refrencing bug please find all updations in the updates.md file
    [motorcontroller.py, servo.ino]
