Irfan4hmd/Entomoscope_LIB/(notices)

Notices in the files:
enimas2-main/README.md:
Software license: MIT
Hardware license: CERN-OHL-P-2.0
